darklader/BeamBMS/Project Outputs for Beam_BMS_light/Beam_BMS_light.xlsx

Обозначение | Наименование | Количество | Описание | наименование в базе КРОКС | Возможная замена #1
BQ1 | KX–327RT | 1 | Чип резонатор 32.768 кГц | Crystal_KX–327RT<2-SMD>_32.768_kHz_±20ppm_7pF_<Geyer_12.87163>
BQ2 | ABM3B-8.000MHZ-B2-T | 1 | ABM3B-8.000MHZ-B2-T | Crystal_ABM3B<4-SMD>_8MHz_±20ppm_18pF_<ABM3B-8.000MHZ-B2-T>
C4, C5 | CC0603-X5R-4,7 пФ-20%-10В | 2 | Чип конденсатор керамический | CAP_0603_4.7pF_±0.25pF_50V_C0G
C6, C12, C18, C19, C20, C21 | CC0603-X5R-0,1 мкФ-20%-10В | 6 | Чип конденсатор керамический | CAP_0603_100nF_10%_50V_X7R
C9, C10 | CC0603-X5R-18 пФ-20%-10В | 2 | Чип конденсатор керамический | CAP_0603_18pF_5%_50V_C0G
C13 | CC0603-X5R-1 мкФ-20%-10В | 1 | Чип конденсатор керамический | CAP_0603_1uF_10%_10V_X5R
C14, C15, C16, C17 | CT-10V-22uF-±20%-C | 4 | Чип конденсатор танталовый | TC_2312(C)_22uF_10%_16V_<Vishay_593D226X9016C2TE3>
C25, C56 | CC1206-X7R-22 мкФ-20%-35В | 2 | Чип конденсатор керамический | CAP_1206_22uF_20%_35V_X5R
C26, C55, C58, C59, C67 | CC0402-X7R-0,1 мкФ-20%-50В | 5 | Чип конденсатор керамический | CAP_0402_100nF_10%_50V_X7R
C44, C45, C75, C76, C78, C81, C82, C84 | CC0603-X7R-0,1 мкФ-20%-50В | 8 | Чип конденсатор керамический | CAP_0603_100nF_10%_50V_X7R
C57, C66 | CC0402-X7R-10 нФ-20%-50В | 2 | Чип конденсатор керамический | CAP_0402_10nF_10%_50V_X7R
C60 | CC0603-X7R-10 мкФ-20%-50В | 1 | Чип конденсатор керамический | CAP_0603_10uF_20%_25V_X5R
C63, C80 | CA-16V100 мкФ-±20%-D (0605) | 2 | SMD ELECTROLYTIC CAPACITORS | SMD_CAP(ALUM)_6.3*7.7_100uF_16V
C46, C64, C83 | CT-35V-22uF-±20%-D | 3 | Чип конденсатор танталовый | TC_2917(D)_22uF_10%_35V_<Vishay_293D226X9035D2TE3>
C74, C77 | CC1206-X7R-1,0 мкФ-20%-50В | 2 | Чип конденсатор керамический | CAP_1206_1uF_10%_50V_X7R
C79 | CC0603-X7R-100 нФ-20%-50В | 1 | Чип конденсатор керамический | CAP_0603_100nF_10%_50V_X7R
C85 | CC0603-X7R-6,8 нФ-20%-50В | 1 | Чип конденсатор керамический | CAP_0603_6.8nF_10%_50V_X7R
C86 | CC0603-X7R-8,2 пФ-20%-50В | 1 | Чип конденсатор керамический | CAP_0603_8.2pF_±0.25pF_50V_C0G
C87 | CC0603-X7R-11 нФ-20%-50В | 1 | Чип конденсатор керамический | CAP_0603_10nF_10%_50V_X7R
DA1 | MCP6002-I/SN | 1 | MCP6002-I/SN | SOIC-8_MCP6002T-I/SN
DA2 | TEN 8-2411WI | 1 | 9-36V input, 5V, 1.6 A output, 8 Watt dc/dc converter isolated 1500 VDC | DIP-24_9L_Module_DC-DC_Converter_5V_1.6A_<Traco_TEN_8-2411WI>
DA9 | TPS54260 | 1 | 60-V,2.5-A,step-down regulator with an integrated high-side MOSFET | MSOP-10_TPS54260DGQR
DD1 | STM32F103CBT6 | 1 | Medium-density performance line ARM®-based 32-bit MCU with 64 or 128 KB Flash, USB, CAN, 7 timers, 2 ADCs, 9 com. interfaces | LQFP-48_STM32F103CBT6
DD2 | LTC6820HMS#PBF | 1 | isoSPI Isolated Communications Interface | MSOP-16_LTC6820HMS#PBF
DD5 | ADM2582EBRWZ | 1 | Isolated RS-485/RS-422 transceiver, configurable as half or full duplex isoPower® integrated isolated dc-to-dc converter | SOIC-20_ADM2582EBRWZ-REEL7
DD8 | ADuM4122 | 1 | Single Gate, Adjustable Slew Rate, Isolated Gate Driver, 3 A Short-Circuit (<3Ω) | SOIC-8_ADUM4122ARIZ-RL
FP1 | 1812L110/33 | 1 | сраб. 1,1 А, крит.1,95А | FUSE_1812_33V_1.1A_<Littelfuse_1812L110/33MR>
HA1 | HCM1203X | 1 | Пьезокерамический излучатель звука | Buzzers_Indicator_1.5-24V_13.9mm_H6mm_<Sonitron_SMA-13-P7.5>
HL1 | FYLS-0603UGC | 1 | Светодиод зеленый SMD0603 | LED_0603_GREEN
HL2, HL3, HL4 | FYLS-0603UYC | 3 | Светодиод желтый SMD0603 | LED_0603_YELLOW
HL5 | FYLS-0603URC | 1 | Светодиод красный SMD0603 | LED_0603_RED
HL6 | FYLS-0603UBC | 1 | Светодиод синий SMD0603 | LED_0603_BLUE
L1, L12 | BLM15AG-600 Ом | 2 | Чип индуктивность подавления EMP | FB_0402_600_Ohm@100MHz_300mA_<BLM15AG601SN1D>
L2, L4 | BLM18PG-600 Ом | 2 | Чип индуктивность подавления EMP | FB_0603_600_Ohm@100MHz_500mA_<BLM18AG601SH1D>
L3 | BLM18PG-1000 Ом 1,2A | 1 | Чип индуктивность подавления EMP | FB_0603_1K_Ohm@100MHz_600mA_<BLM18HE102SN1D>
L9 | BLM15AG-600 Ом300 mA | 1 | Чип индуктивность подавления EMP | FB_0402_600_Ohm@100MHz_300mA_<BLM15AG601SN1D>
L13 | BLM18PG-330 Ом 1,2A | 1 | Чип индуктивность подавления EMP | FB_0603_330_Ohm@100MHz_1200mA_<BLM18PG331SH1D>
L14 | SRR0603-150ML | 1 | Чип индуктивность 15 мкГн, 900 мА, Экранированный, 1.2 А | IND_SSR0603_<6.5*6.5*3.3_2P>_22uH_20%_<Bourns_SRR0603-220ML>
R39 | CR0402-100-±5% | 1 | Чип резистор | ?? Поставляли на 12S_Monkeys
R6, R7, R9, R11, R13, R104 | CR0603-220-±5% | 6 | Чип резистор | RES_0603_220_Ohm_5%
R8, R10, R85 | CR0603-4,7 кОм-±5% | 3 | Чип резистор | RES_0603_4.7K_Ohm_5%
R17 | CR0603-1 кОм-±5% | 1 | Чип резистор | RES_0603_1K_Ohm_5%
R21, R24, R25, R26, R27, R28, R29, R32, R87, R89 | CR0603-22-±5% | 10 | Чип резистор | RES_0603_22_Ohm_5%
R34 | CR0603-3,9 кОм-±5% | 1 | Чип резистор | RES_0603_3.9K_Ohm_5%
R41 | CR0402-2 кОм-±5% | 1 | Чип резистор | RES_0402_2K_Ohm_5%
R42 | CR0402-3 кОм-±1% | 1 | Чип резистор
R43 | CR0402-1 кОм-±1% | 1 | Чип резистор | RES_0402_1K_Ohm_1%
R61, R83 | CR0603-100 Ом-±5% | 2 | Чип резистор | RES_0603_100_Ohm_5%
R73, R103 | CR0603-10 кОм-±1% | 2 | Чип резистор | RES_0603_10K_Ohm_1%
R74 | CR0603-6,49 кОм-±1% | 1 | Чип резистор | RES_0603_6.49K_Ohm_1%
R75 | CR0603-1,5 кОм-±1% | 1 | Чип резистор | RES_0603_1.5K_Ohm_5%
R76 | CR0603-2,5 кОм-±1% | 1 | Чип резистор | RES_0603_2.49K_Ohm_1%
R84, R86 | CR0603-100-±5% | 2 | Чип резистор | RES_0603_100_Ohm_5%
R95, R96, R110, R111 | CR1206-10 Ом-±5% | 4 | Чип резистор | RES_1206_10_Ohm_5%
R97 | CR0603-10 кОм-±5% | 1 | Чип резистор | RES_0603_10K_Ohm_5%
R98 | CR0603-105 кОм-±1% | 1 | Чип резистор | RES_0603_105K_Ohm_1%
R99 | CR0603-31,6 кОм-±1% | 1 | Чип резистор | RES_0603_31.6K_Ohm_1%
R100 | CR0603-54,9 кОм-±1% | 1 | Чип резистор | RES_0603_54.9K_Ohm_1%
R101 | CR0603-249 кОм-±5% | 1 | Чип резистор | RES_0603_249K_Ohm_1%
R102 | CR0603-18,2 кОм-±5% | 1 | Чип резистор | RES_0603_18.2K_Ohm_1%
R107, R109 | CR0603-20 кОм-±5% | 2 | Чип резистор | RES_0603_20K_Ohm_5%
T1 | TG110-AE050N5LFTR | 1 | Halo's <b>TG110-AE050N5LFTR</b> ULTRA-Series, 16 Pin SOIC 10/100BASE-TX Magnetic Modules<br> <br> <b>Description:</b><br> <br> | Pulse_Transformers_HALO_TG110-AE050N5LF_REEL_ONLY
VD3, VD4, VD5, VD6 | BAV99 | 4 | Диоды | SOT23-3_BAV99.215
VD9 | MBRA340T3 | 1 | Диод шотки I=3А V=40В | DO-214AC_MBRA340T3G
VD10 | PSM712 | 1 | ESD RS-485 | SOT23-3_SM712.TCT
X1 | MOLEX 1053131102 | 1 | Connector, 2pin, 2.5mm, 1500VDC, 6.5A | ?? Поставляли на 12S_Monkeys
XP1 | S03B-PASK-2 | 1 | Вилка угловая выводная, шаг 2мм | Connector_Header_S03B-PASK-2_3P_2.0mm_TH_<JST_S03B-PASK-2(LF)(SN)>
XP3 | 1565749-3 | 1 | TH/.025 Connector System, Automotive Headers, 4 Position, 2.2mm [.087in] Centerline, Horizontal, 1 Row, Gray, Through Hole - Solder, Tin (Sn) | Connector_Header_Panel_Mount_Right_Angle_4P_2.2mm_TH_<TE_1565749-3>
XP4 | 1-1379684-1 | 1 | TH/.025 Connector System, Automotive Headers, 8 Position, 2.2mm [.087in] Centerline, Horizontal, 2 Row, Black, Through Hole - Solder, Tin (Sn) | Connector_Header_Panel_Mount_Right_Angle_8P_2.2mm_TH_<TE_1379684-1>
XP5 | DS1022-1x6R | 1 | Штыри на плату однорядные угловые, 6 контактов
