darklader/BeamBMS/Beam_BMS_light.pdf

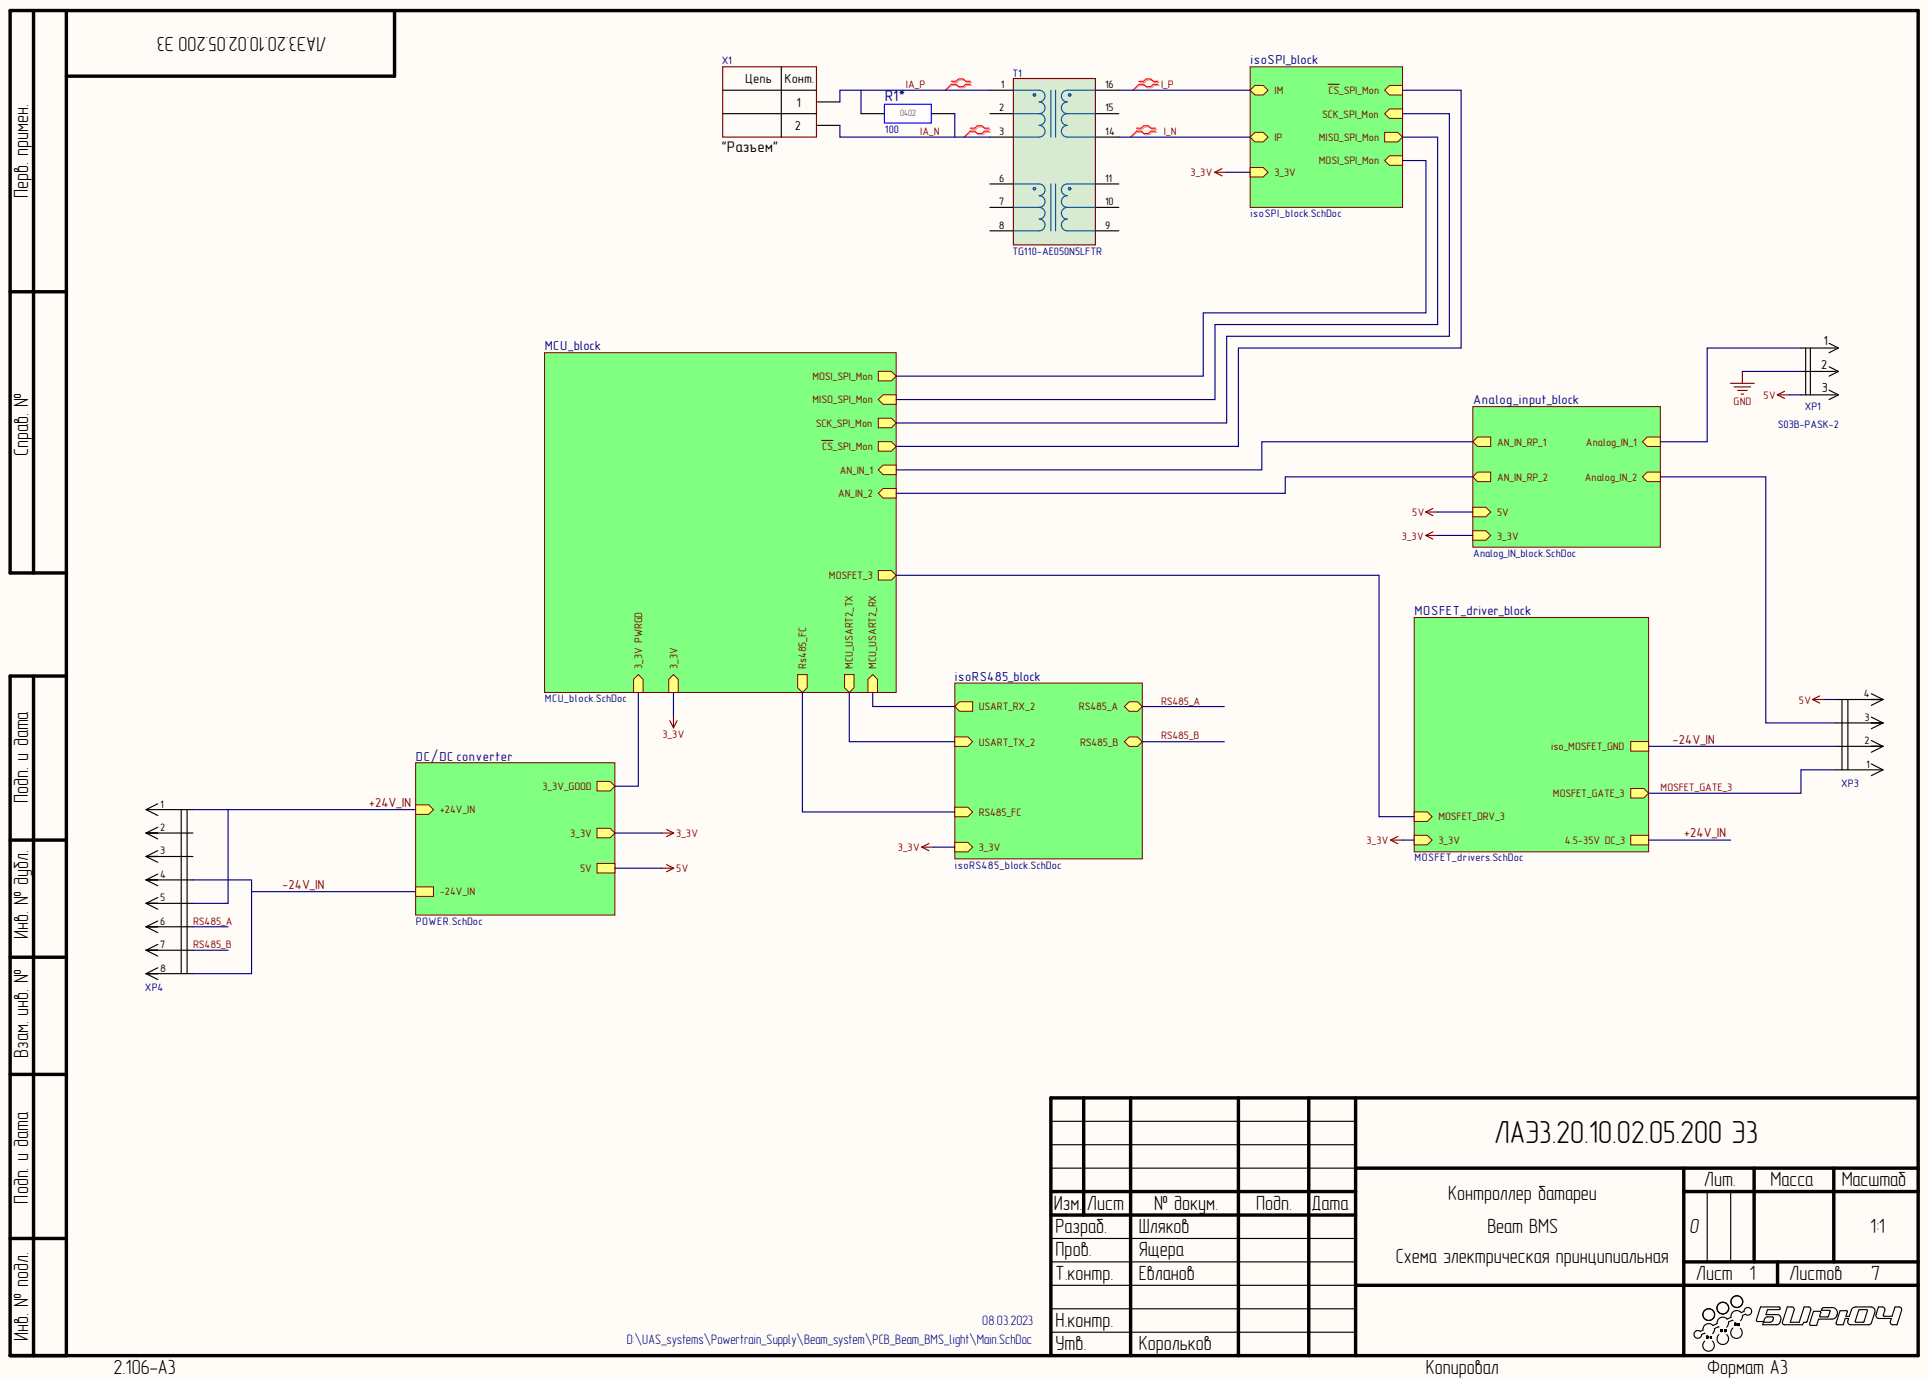
[picture p1: page 1]

Инв. № подл. Инв. № дубл. Подп. и дата Взам. инв. № Подп. и дата Перв. примен. Справ. №

ЛАЭ3.20.10.02.05.200 Э3

Контроллер батареи Beam BMS Схема электрическая принципиальная | Лит. | Масса | Масштаб

Изм. | Лист | № докум. | Подп. | Дата | | O | | | 1:1
Разраб. | | Шляков
Пров. | | Ящера
Т.контр. | Евланов | | | | Лист | Листов 7

Н.контр.
Утв. | Корольков

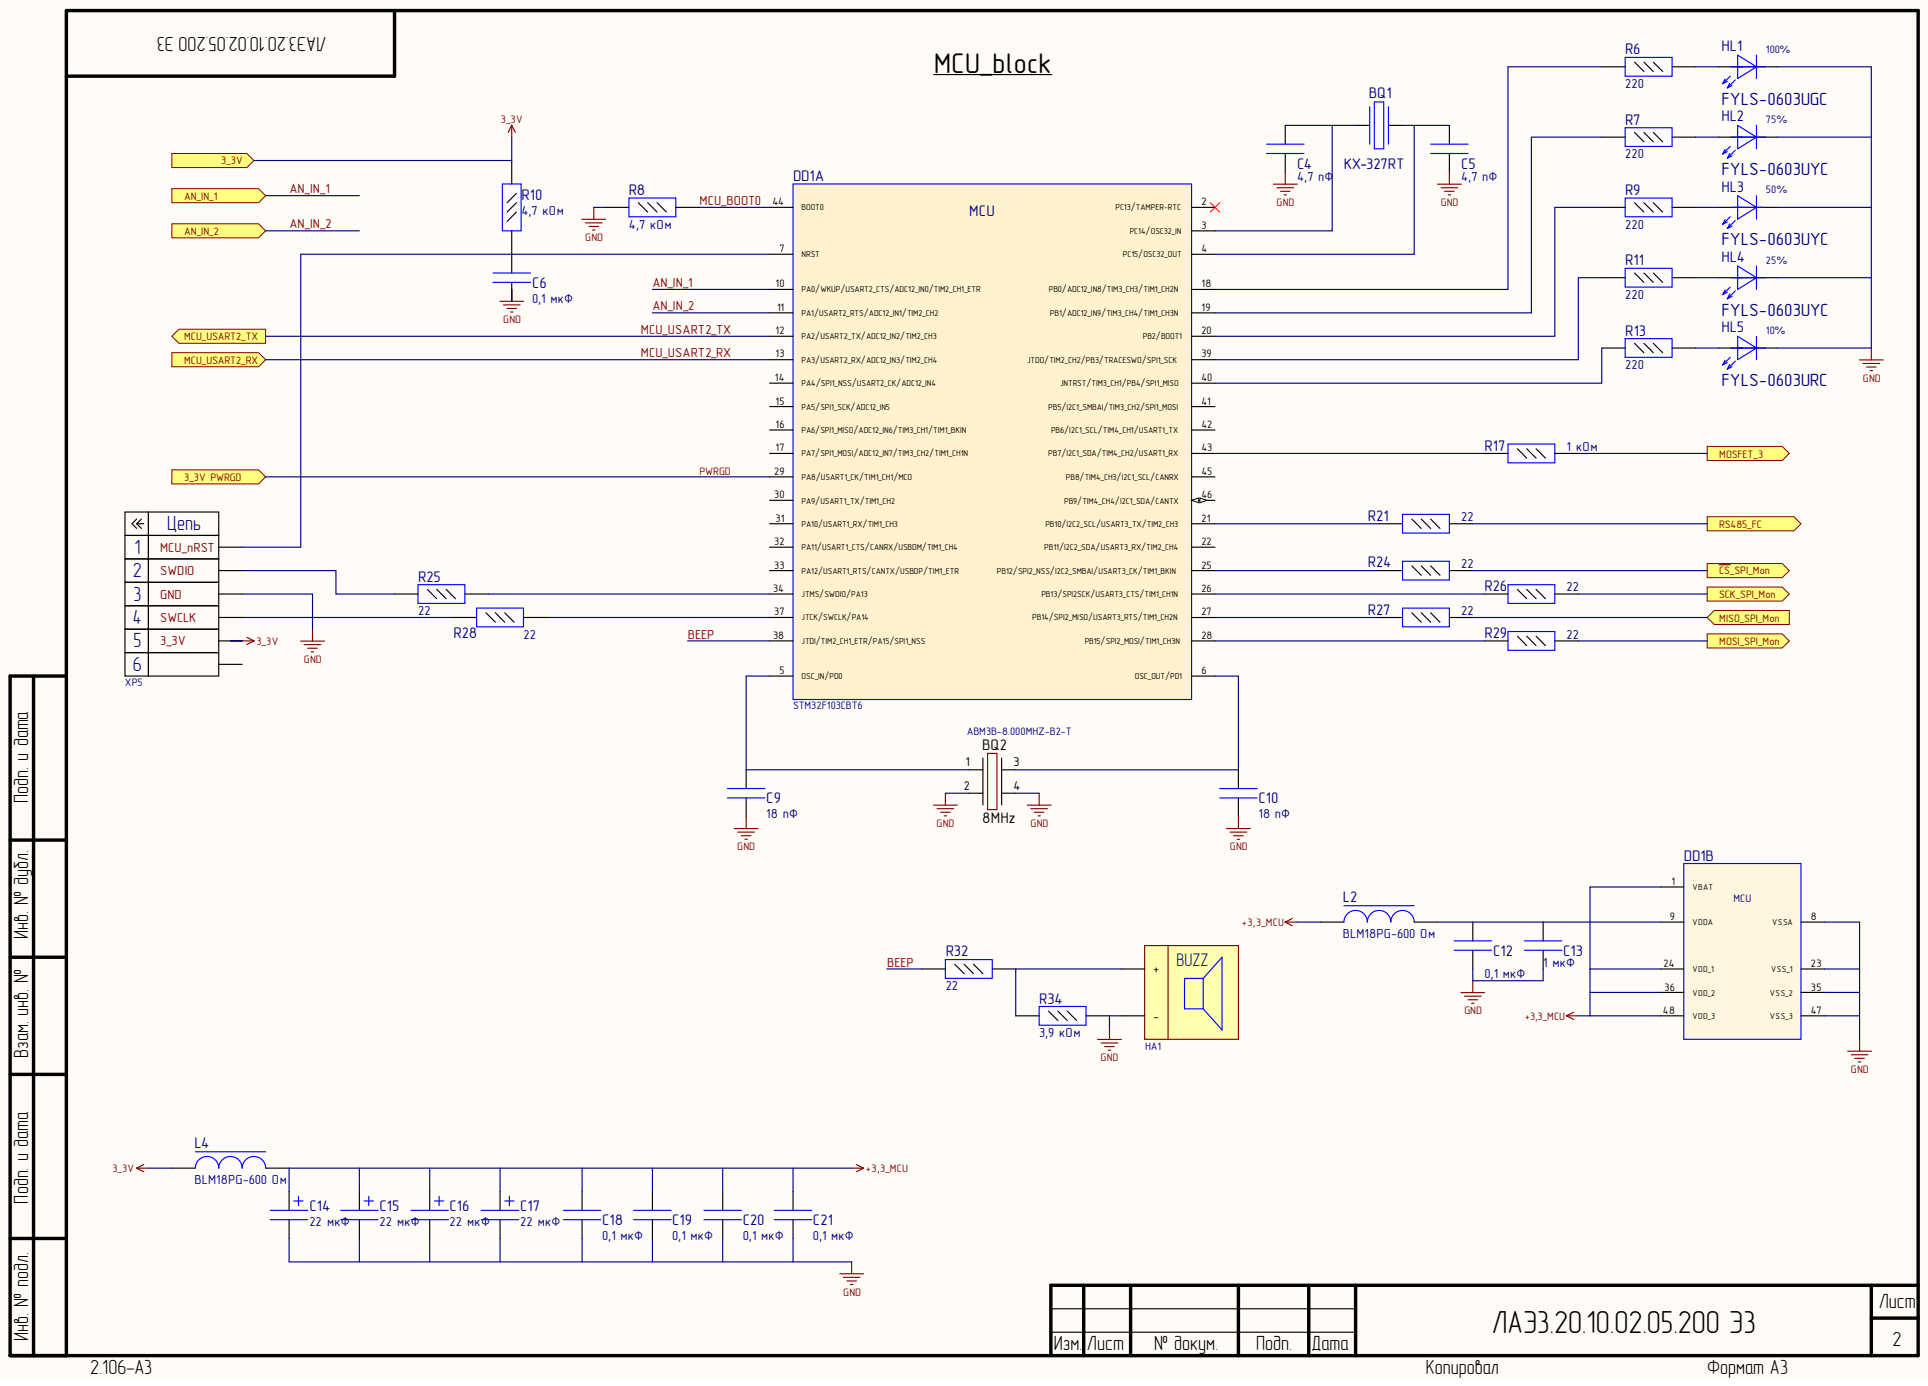
[picture p2: page 2]

NRST 7 | | FYLS-0603UYC HL4 25%

PA0/WKUP/USART2_CTS/ADC12_IN0/TIM2_CH1_ETR 10

Цепь

1 | MCU_nRST

2 | SWDIO

3 | GND
4 | SWCLK | 22
5 | 3_3V

Инв. № подл. Инв. № дубл. Подп. и дата Взам. инв. № Подп. и дата

VDD_3 48

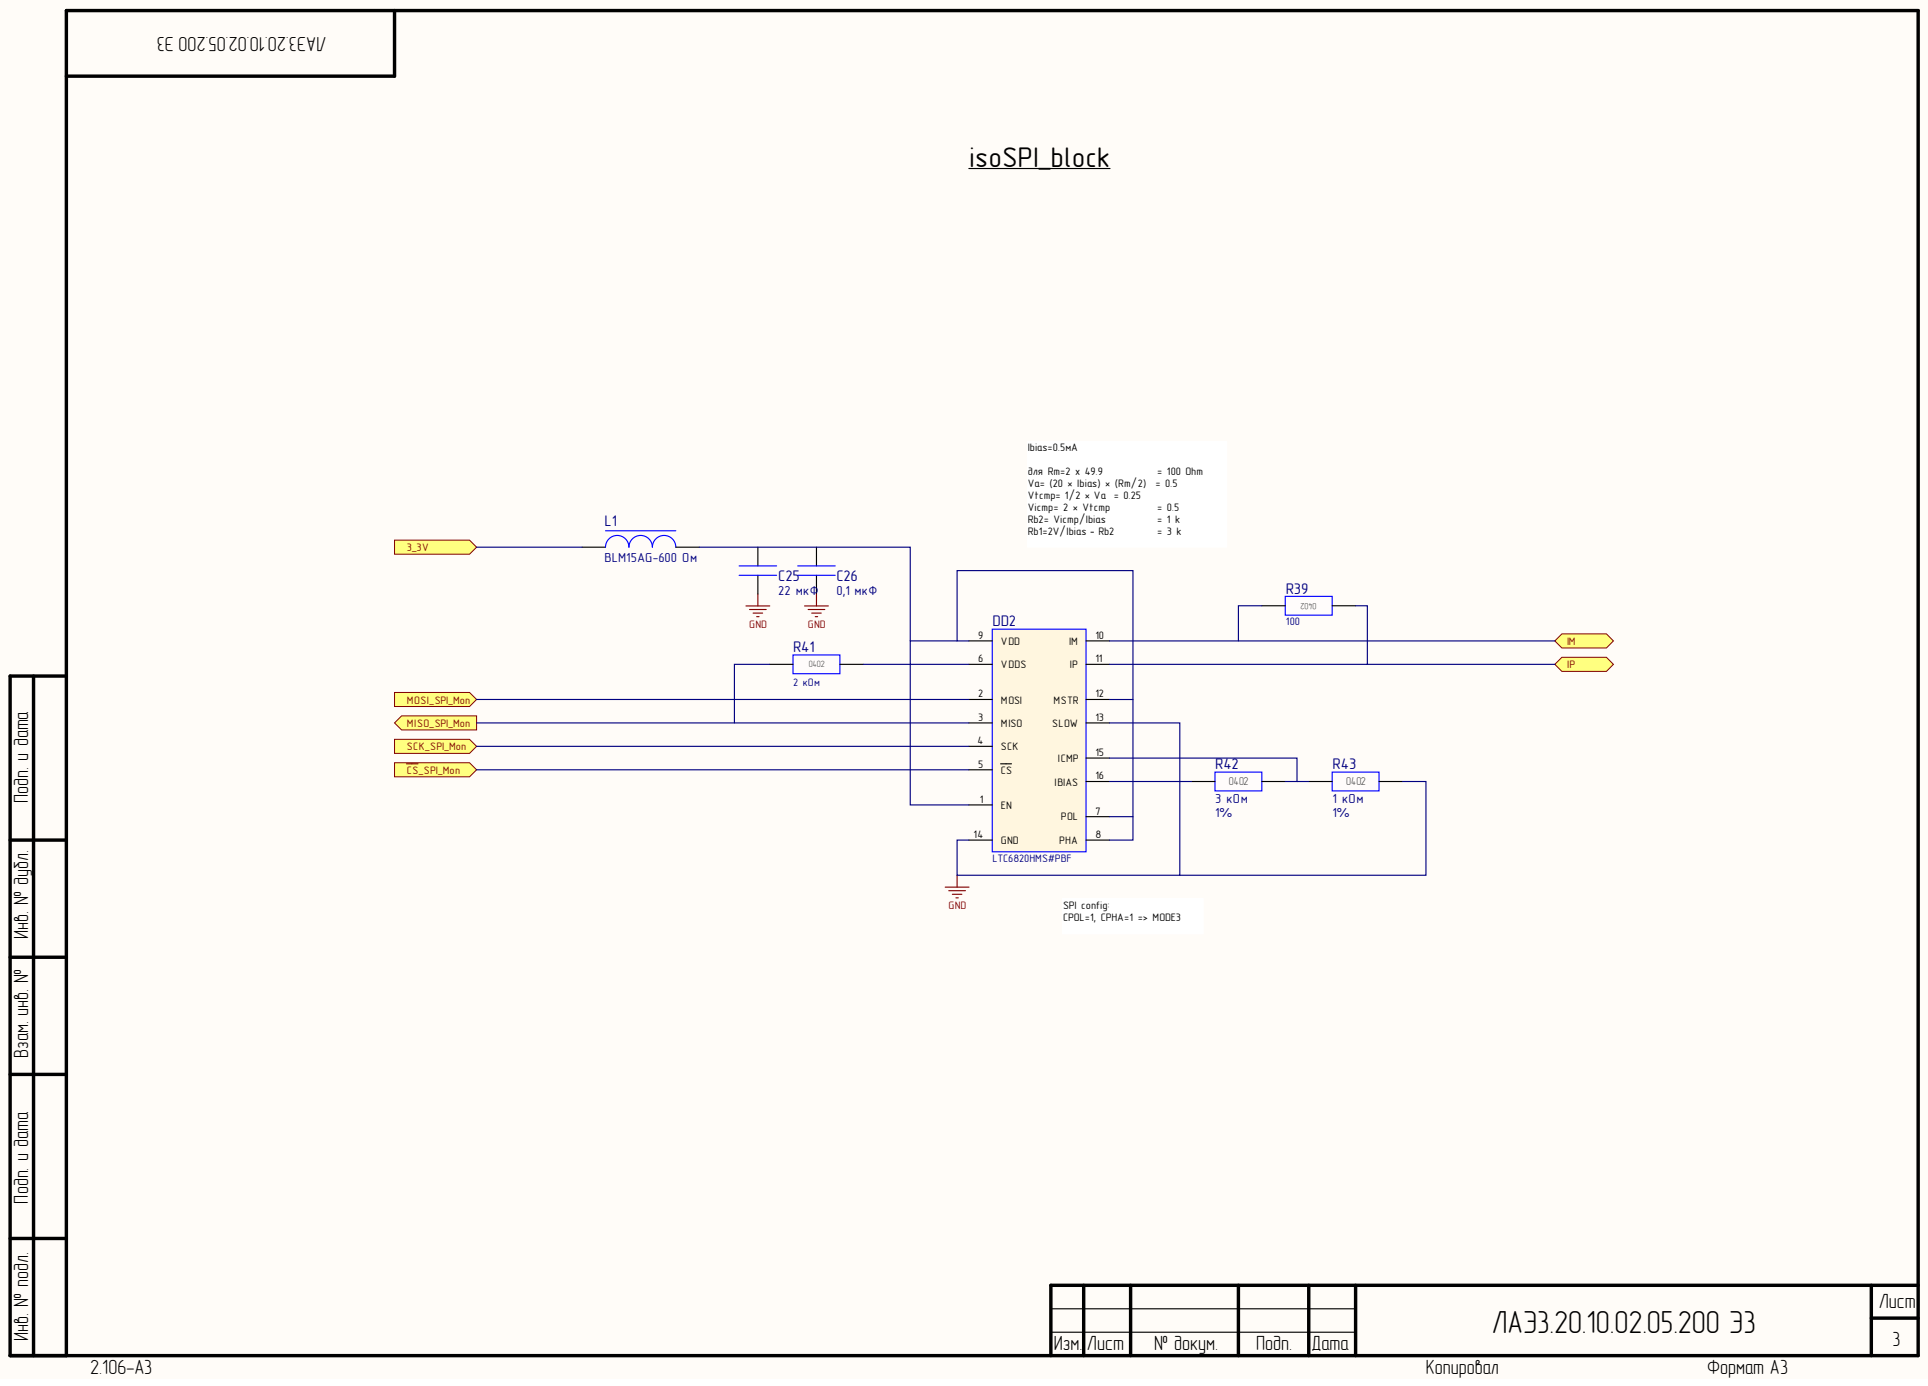
[picture p3: page 3]

Инв. № подл. Инв. № дубл. Подп. и дата Взам. инв. № Подп. и дата

1 5
1 6 | R4 2

ЛАЭ3.20.10.02.05.200 Э | Лист3

Изм | . | № докум . | Подп . | Дата

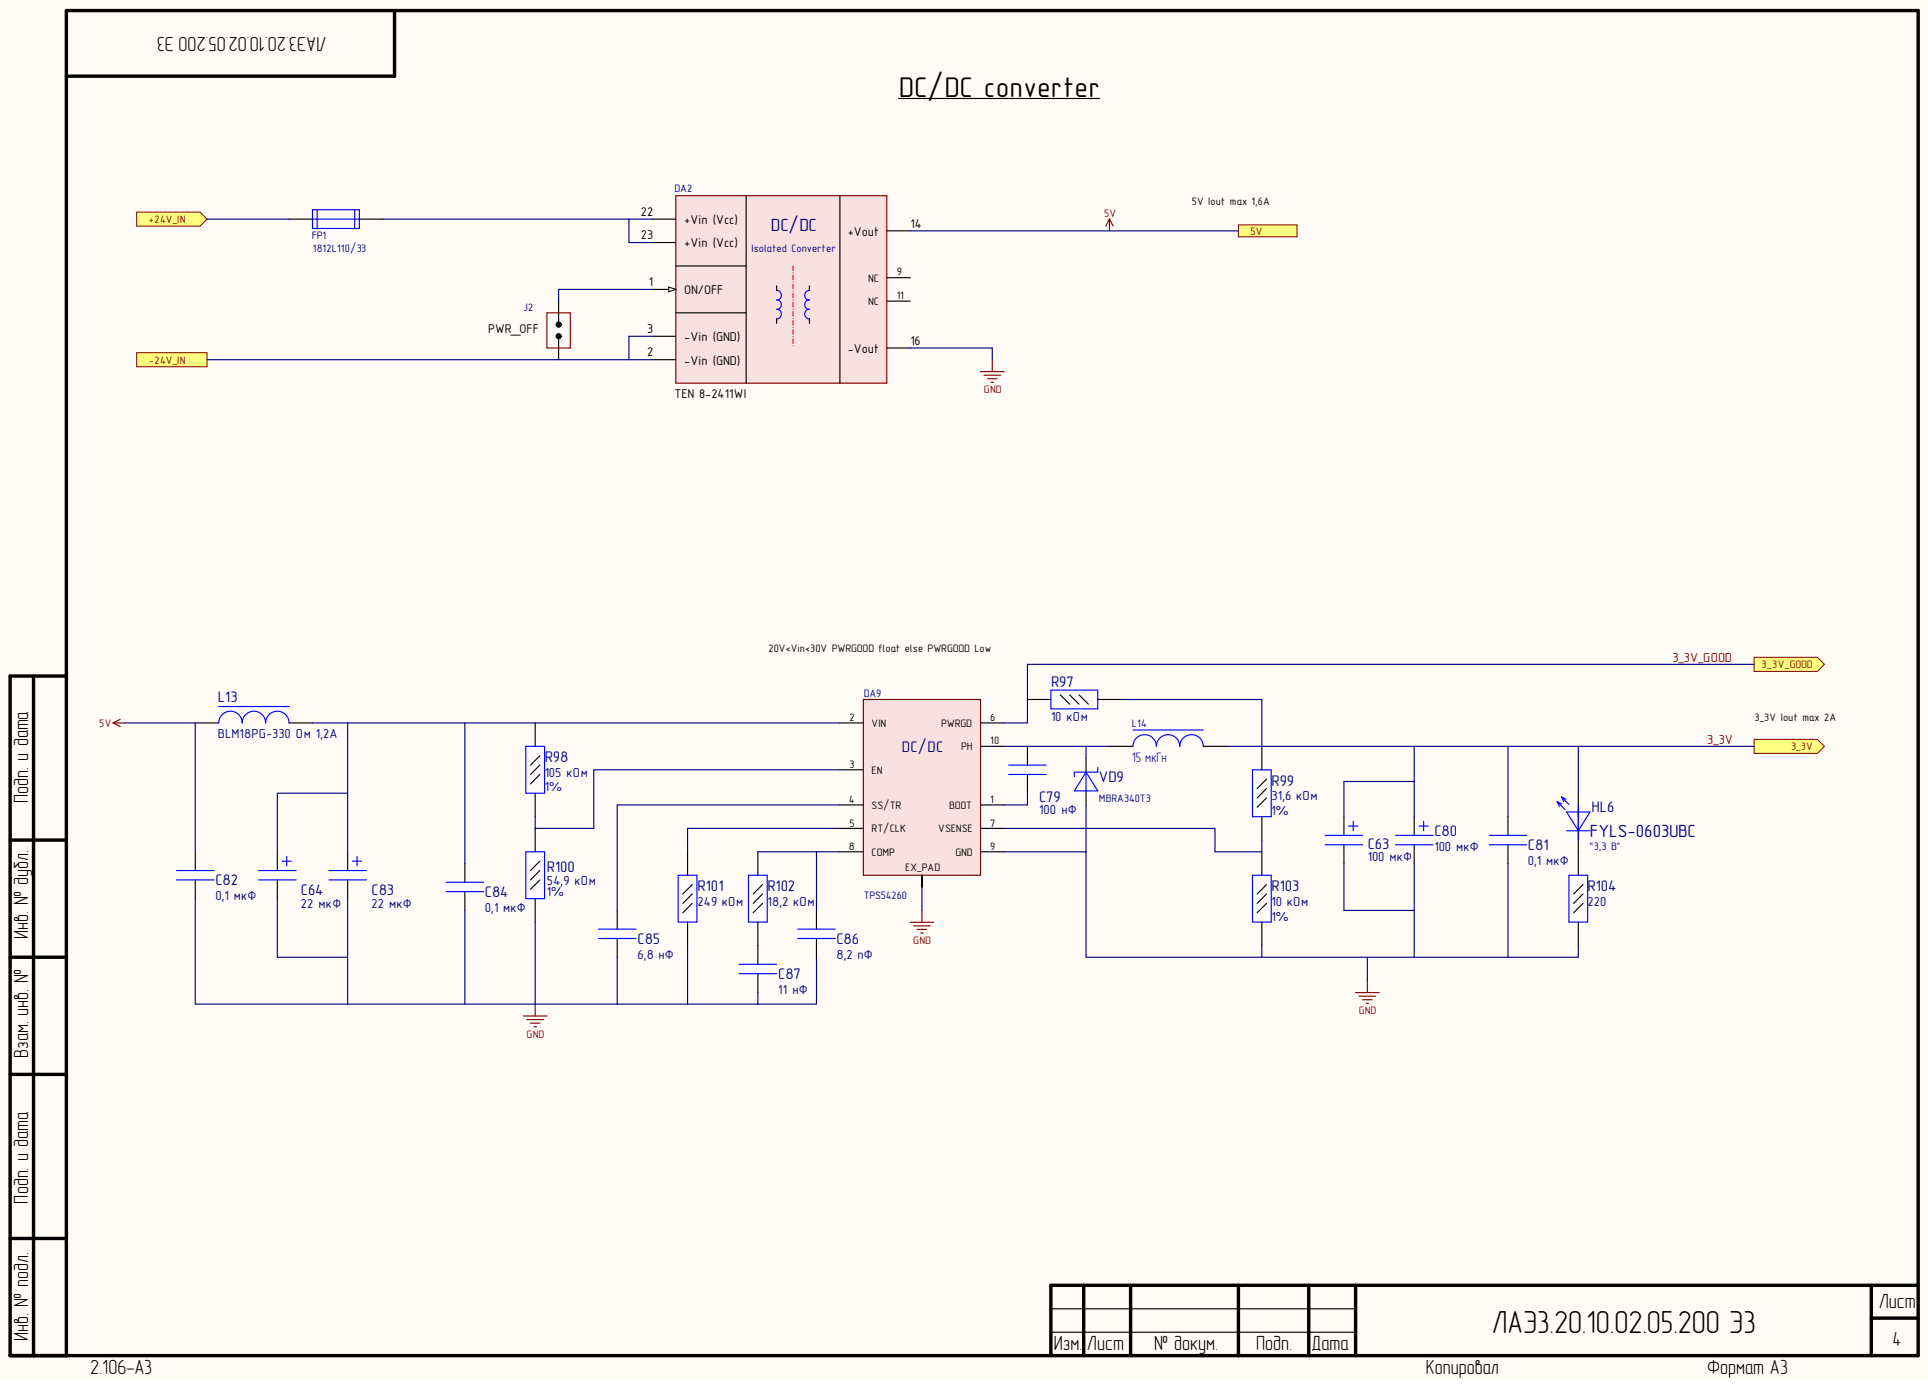
[picture p4: page 4]

20V<Vin<30V PWRGOOD float else PWRGOOD Low

Инв. № подл. Инв. № дубл. Подп. и дата Взам. инв. № Подп. и дата

VIN 2 PH EN 3 EX_PAD | 10 DC/DC | L14

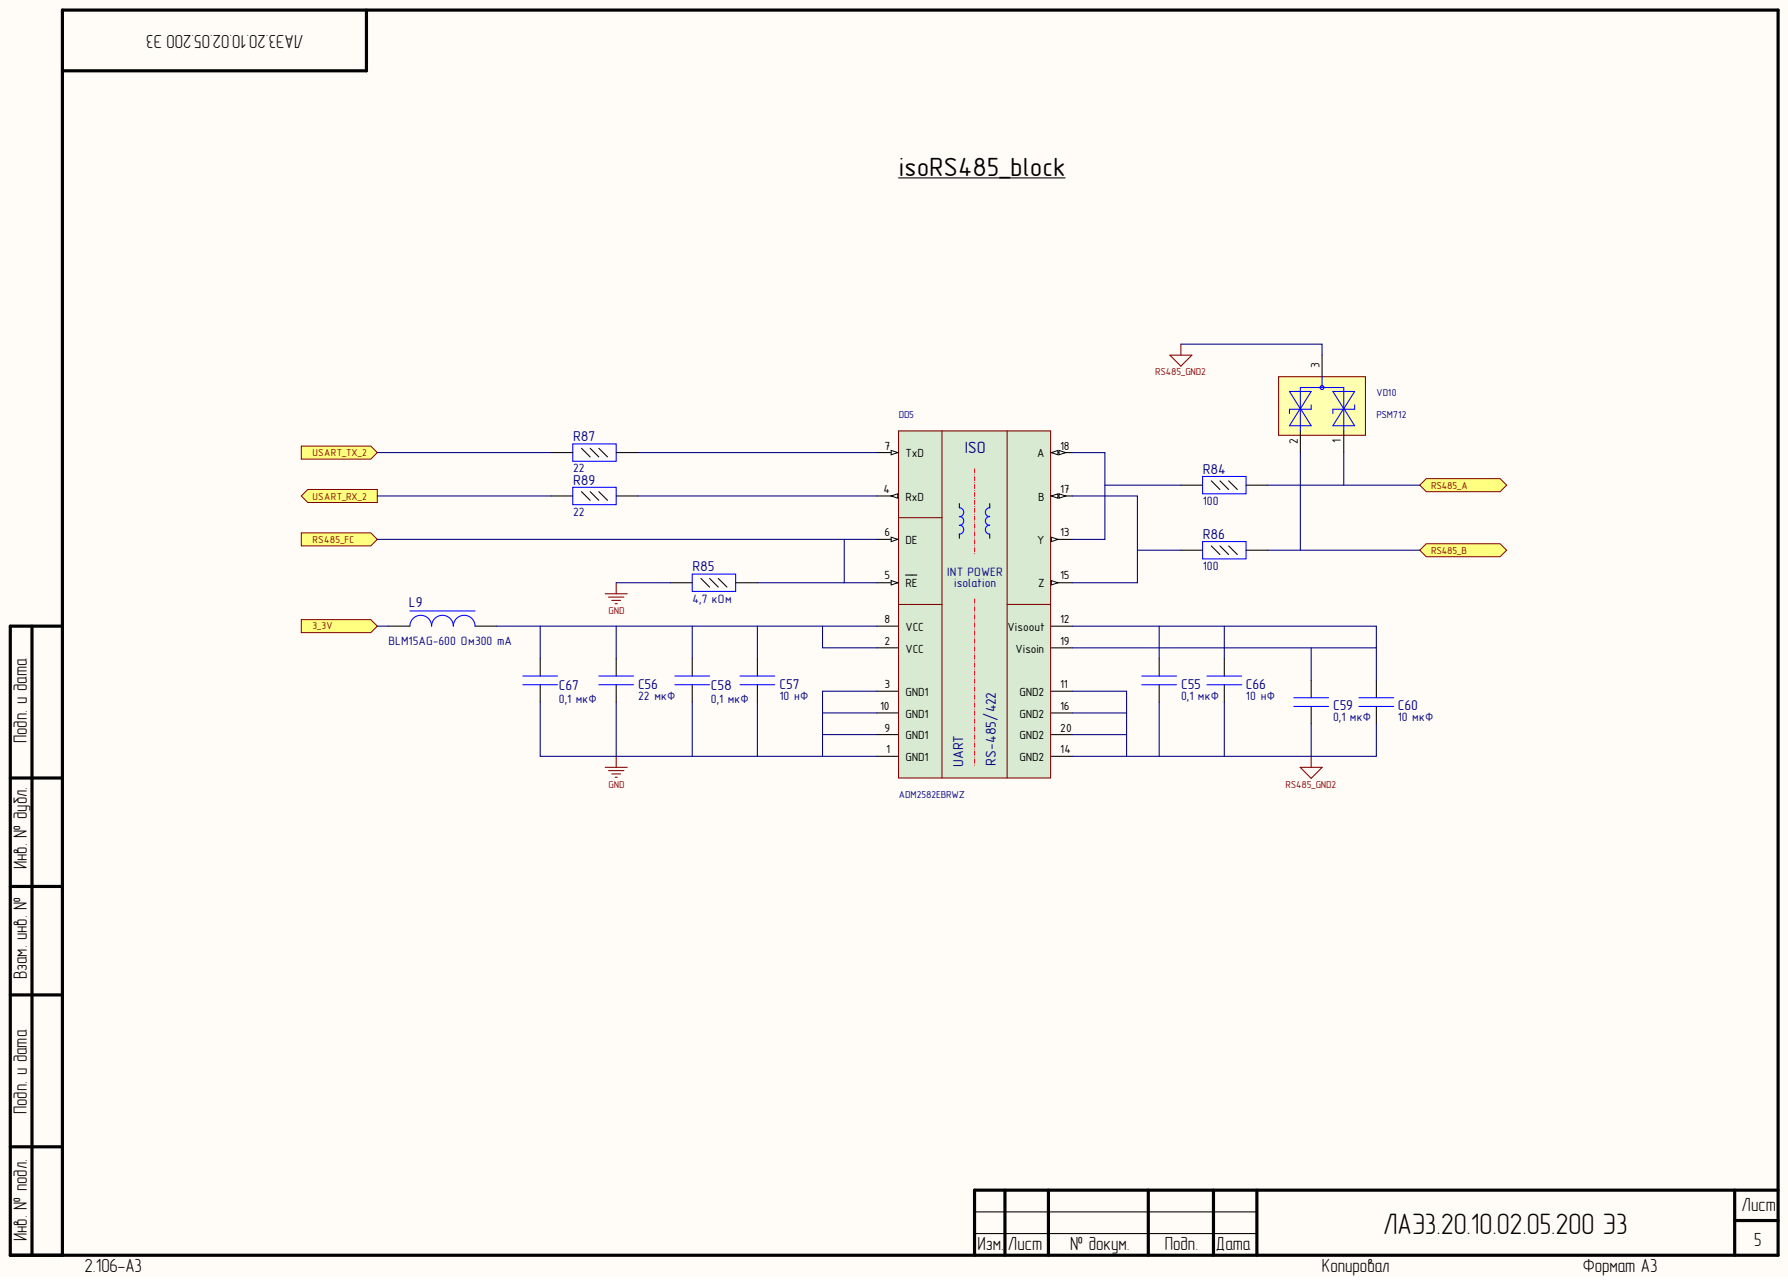
[picture p5: page 5]

Инв. № подл. Инв. № дубл. Подп. и дата Взам. инв. № Подп. и дата

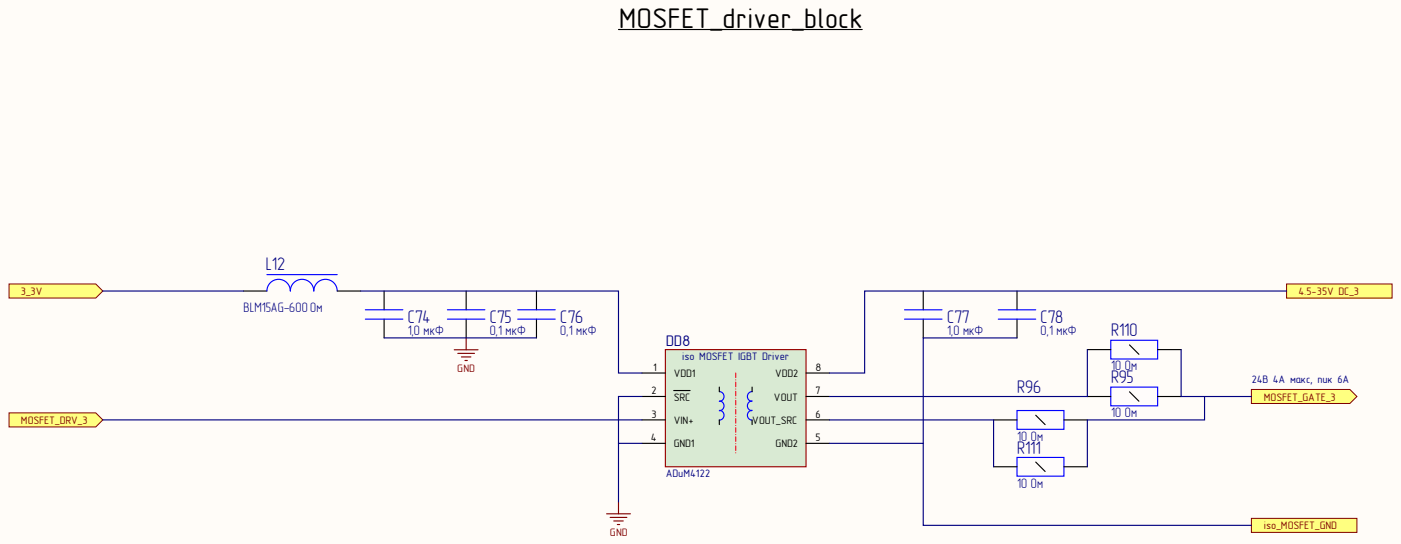
[picture p6: page 6]

Инв. № подл. Инв. № дубл. Подп. и дата Взам. инв. № Подп. и дата

ЛАЭ3.20.10.02.05.200 Э | Лист6

Изм | . | № докум . | Подп . | Дата

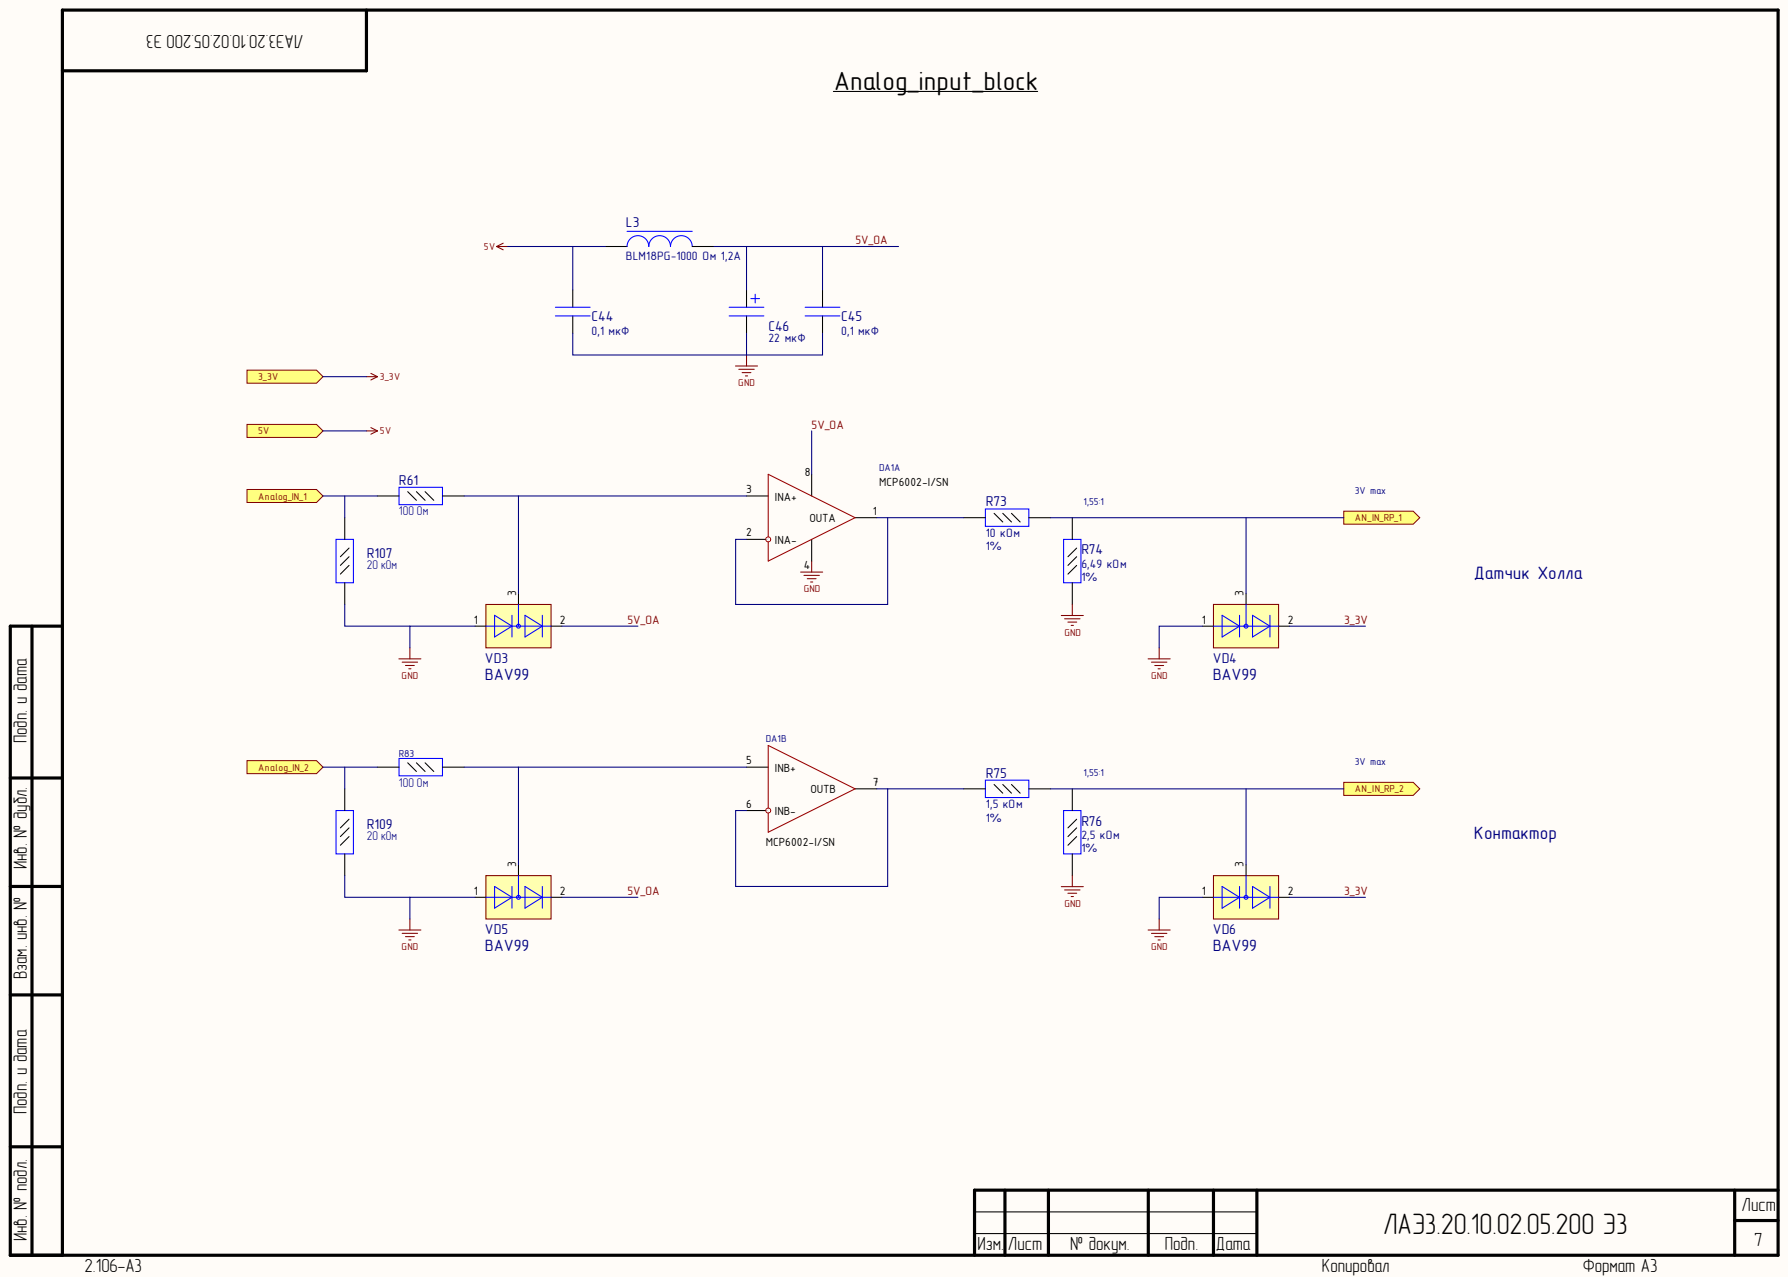
[picture p7: page 7]

Инв. № подл. Инв. № дубл. Подп. и дата Взам. инв. № Подп. и дата
