darklader/BeamBMS/Project Outputs for Beam_BMS_light/BeamBMS_light.pdf

# C85C⁸⁴

## View from Top side (Scale 2:1)

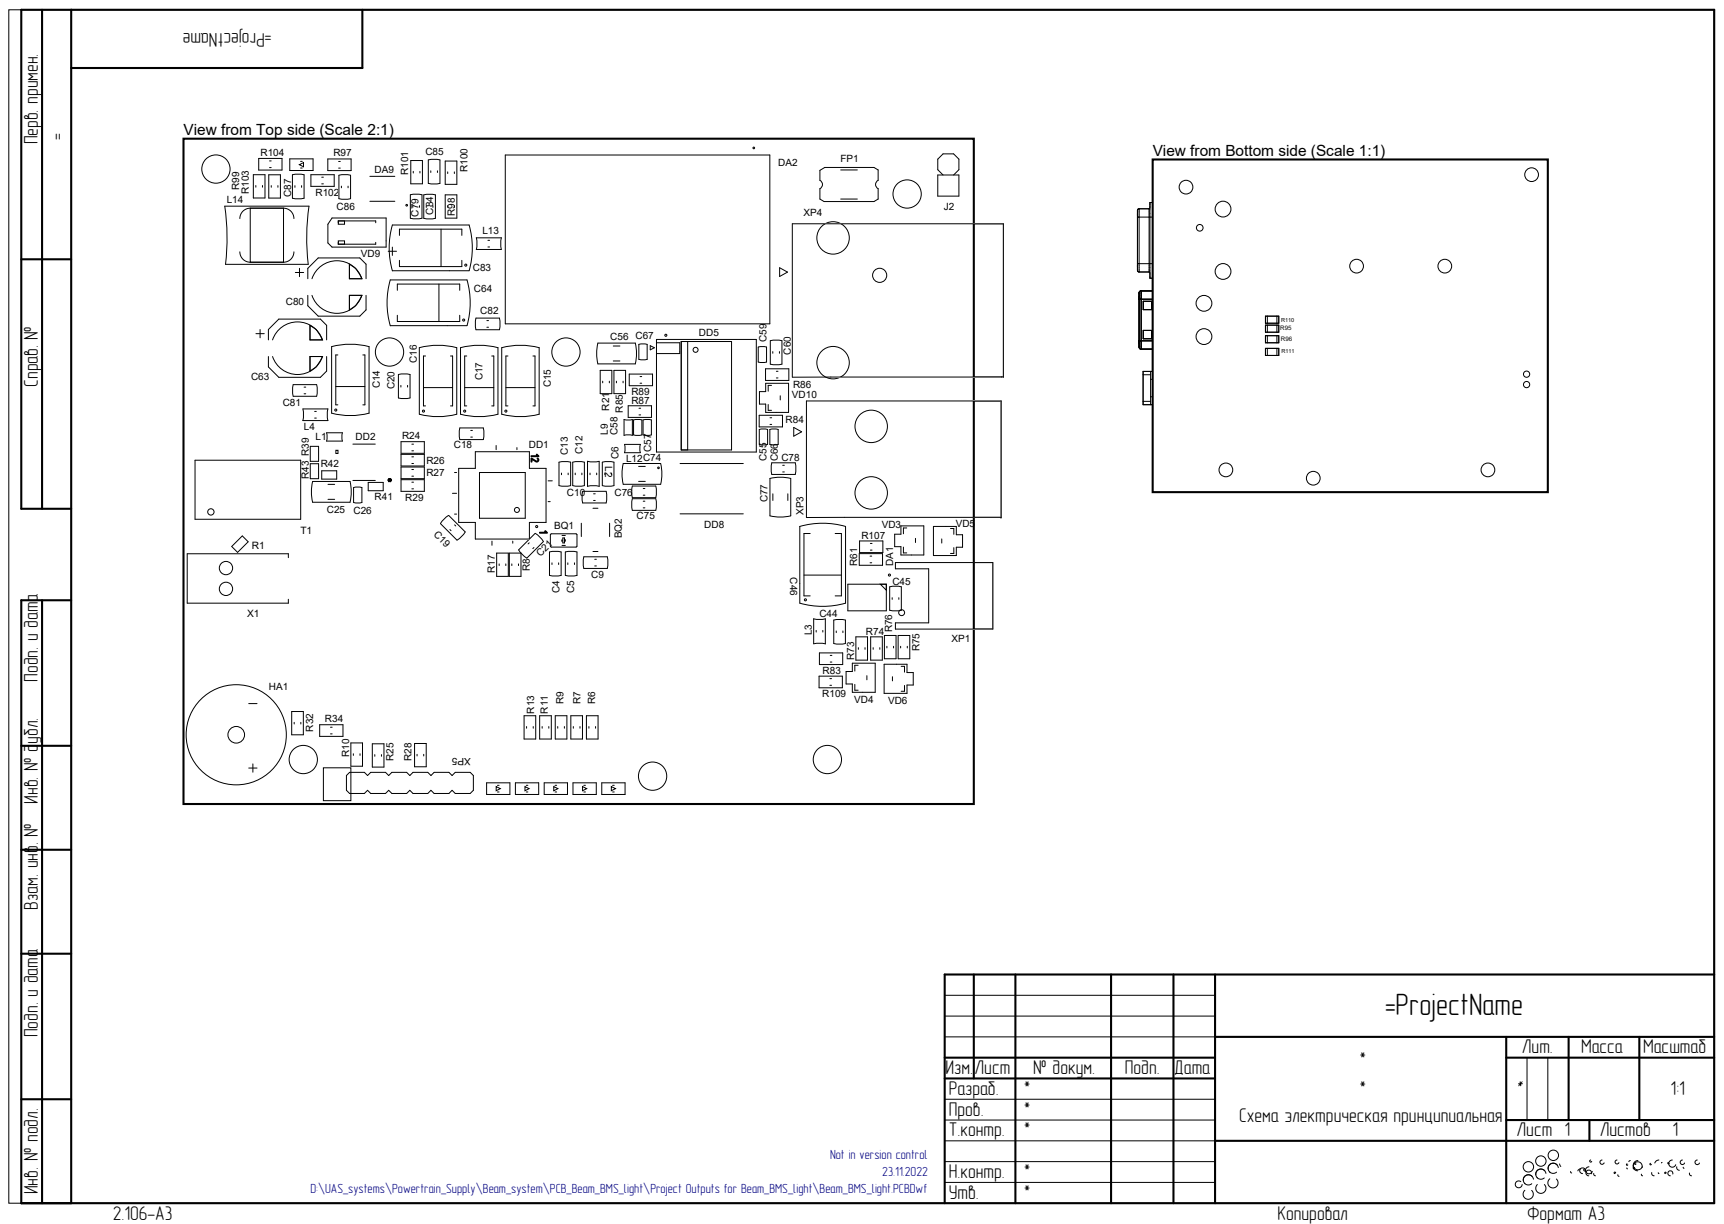
[picture p8: page 1]

Инв. № подл. Инв. № дубл. Подп. и дата Взам. инв. № Подп. и дата Перв. примен. Справ. №

View from Bottom side (Scale 1:1)

=ProjectName

* * Схема электрическая принципиальная | Лит. | Масса | Масштаб

Изм. | Лист | № докум. | Подп. | Дата | | | | | 1:1
Разраб. | | *
Пров. | | *
Т.контр. | * | | | | Лист 1 | Листов 1

Not in version control

Н.контр. | *
Утв. | *

D:\UAS_systems\Powertrain_Supply\Beam_system\PCB_Beam_BMS_light\Project Outputs for Beam_BMS_light\Beam_BMS_light.PCBDwf
