darklader/BeamBMS/(list of files, drawings)

Other design files:
Analog_IN_block.SchDoc
Beam_BMS_light.PrjPcb
isolation_block.SchDoc
isoRS485_block.SchDoc
isoSPI_block.SchDoc
Main.SchDoc
MCU_block.SchDoc
MOSFET_drivers.SchDoc
POWER.SchDoc
