darklader/BeamBMS/(commit log)

2023-03-08 mod: вырез контура платы, перемещены элементы вглубь платы - под гайку в луче разъем датчика тока сдвинут в разъему контактора, чтобы не мешать выводу провода с акб. передвинуты элементы аналогового 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
    [Analog_IN_block.SchDoc, MCU_block.SchDoc, MOSFET_drivers.SchDoc, Main.SchDoc, POWER.SchDoc, isoRS485_block.SchDoc, isoSPI_block.SchDoc]
2023-03-08 Board cut
    [Beam_BMS_light.xlsx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]
2023-03-08 Board cut_
    [Beam_BMS_light.GBL, Beam_BMS_light.GBO, Beam_BMS_light.GBS, Beam_BMS_light.GTL, Beam_BMS_light.GTO, Beam_BMS_light.GTS]
